FabioSalgado01/ESP32-walkie-talkie/FewParts.jpg

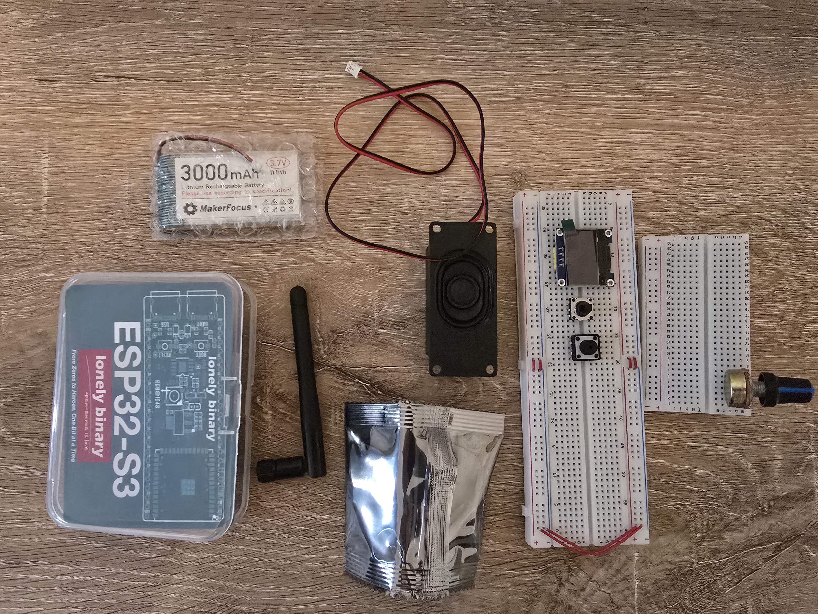
FewParts.jpg
