FabioSalgado01/ESP32-walkie-talkie/finalWalkie.jpg

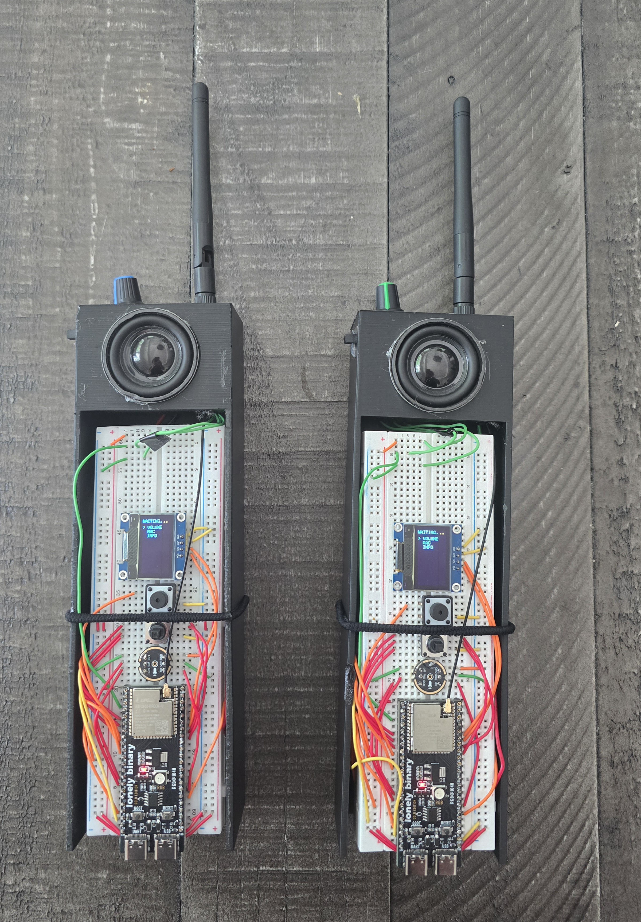
finalWalkie.jpg
