FabioSalgado01/ESP32-walkie-talkie/layoutIdea.jpg

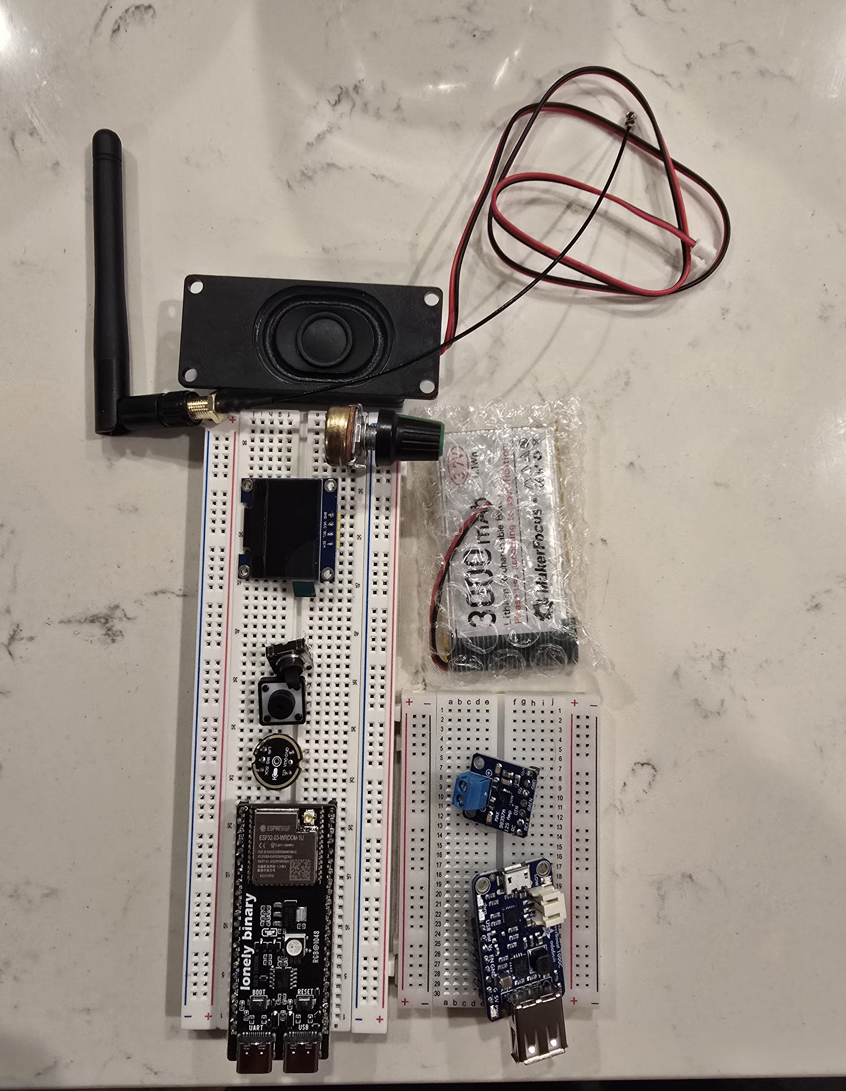
layoutIdea.jpg
