FabioSalgado01/ESP32-walkie-talkie/WalkieSkeleton.jpg

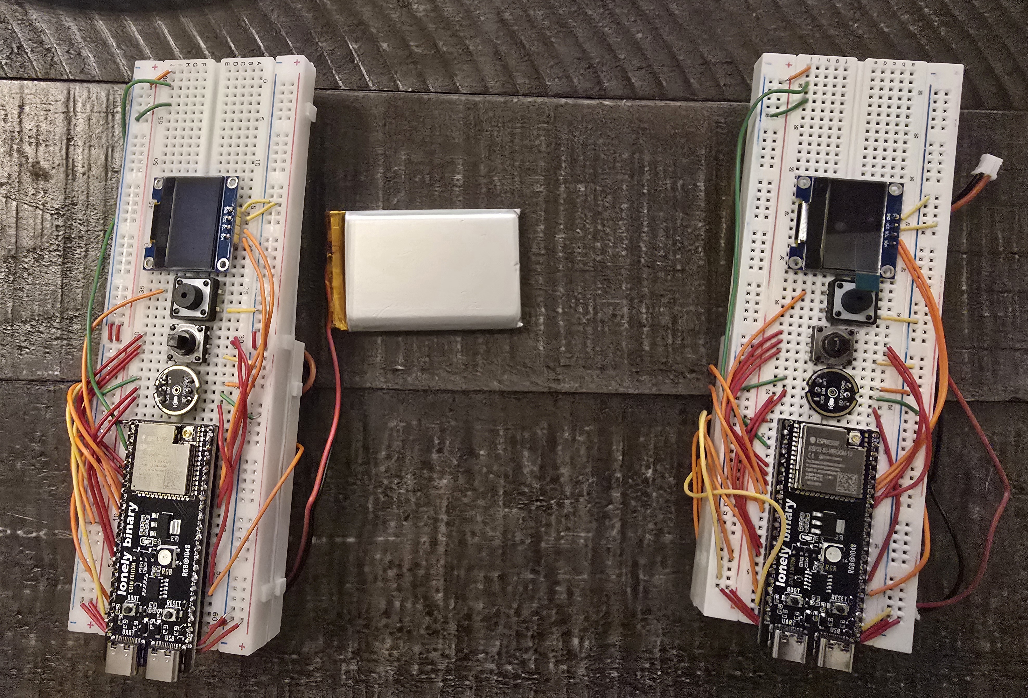
WalkieSkeleton.jpg
