FabioSalgado01/ESP32-walkie-talkie/WalkieCircuitDiagram.pdf

# FRONT SIDE CONNECTIONS

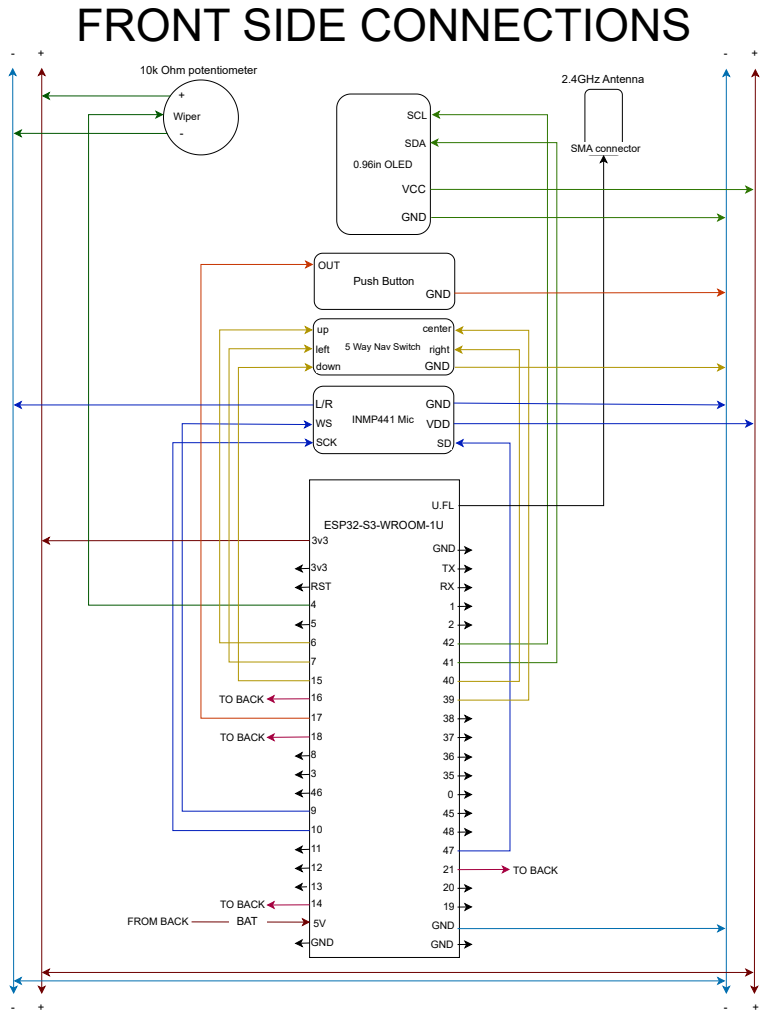
[picture p5: page 1]
0.96in OLED; INMP441 Mic; Push Button; SCK; TO BACK; GND; RST; Wiper; OUT; SCL; SDA; right; center; ESP32-S3-WROOM-1U; SMA connector; 2.4GHz Antenna; 10k Ohm potentiometer; FROM BACK; BAT; VCC; VDD

5 Way Nav Switch
left
down

# BACK SIDE CONNECTIONS

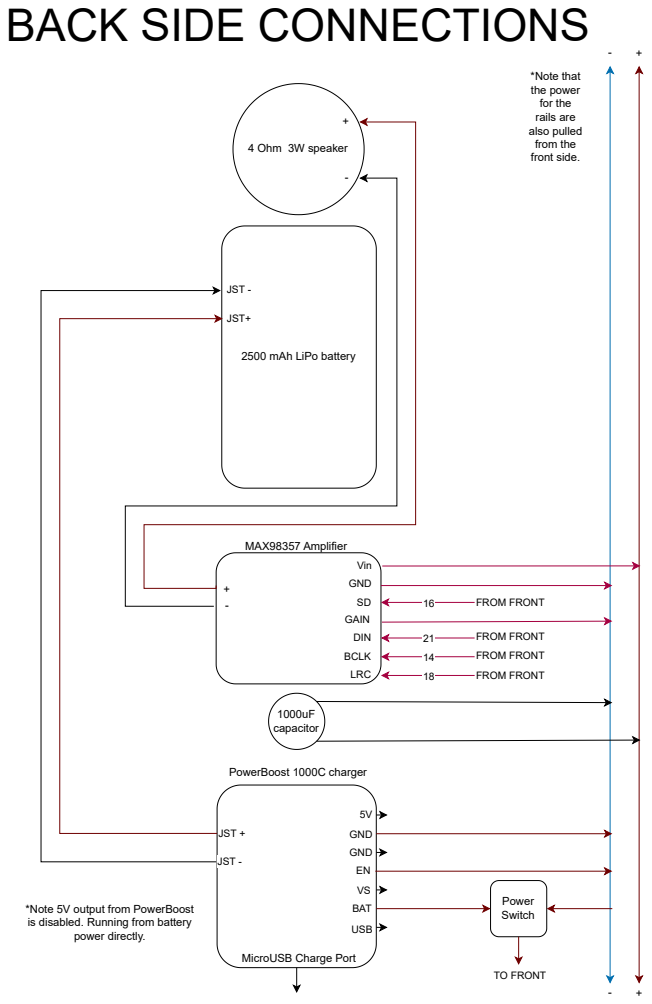
[picture p6: page 2]
PowerBoost 1000C charger; MAX98357 Amplifier; 4 Ohm 3W speaker; Power Switch; GND; BAT; TO FRONT; USB; 1000uF capacitor; *Note that the power for the rails are also pulled from the front side.; JST +; JST+; JST -; Vin; FROM FRONT; GAIN; DIN; BCLK; LRC; power directly.

2500 mAh LiPo battery

*Note 5V output from PowerBoost
is disabled. Running from battery

MicroUSB Charge Port
